AustinHackers/ahabadge/README.md

# AHA Badges

## DEF CON 24

See the [DEF CON 24](https://github.com/AustinHackers/ahabadge/tree/master/DEFCON%2024) sub folder under the master branch.

### v2

See the [version_2.x branch](https://github.com/AustinHackers/ahabadge/tree/version_2.x).

## Getting Help

Open an Issue but don't expect much.
