AustinHackers/ahabadge/DEFCON 24/README.md

# WARNING

Some v0 and v1 badges fail when plugged in to USB,
the MCU develops a short and destroys itself!

If you have a v0 or v1 badge install a 10uF cap between pins 4 and 8
(VSS and VREGIN) on the BREAKOUT1 header.

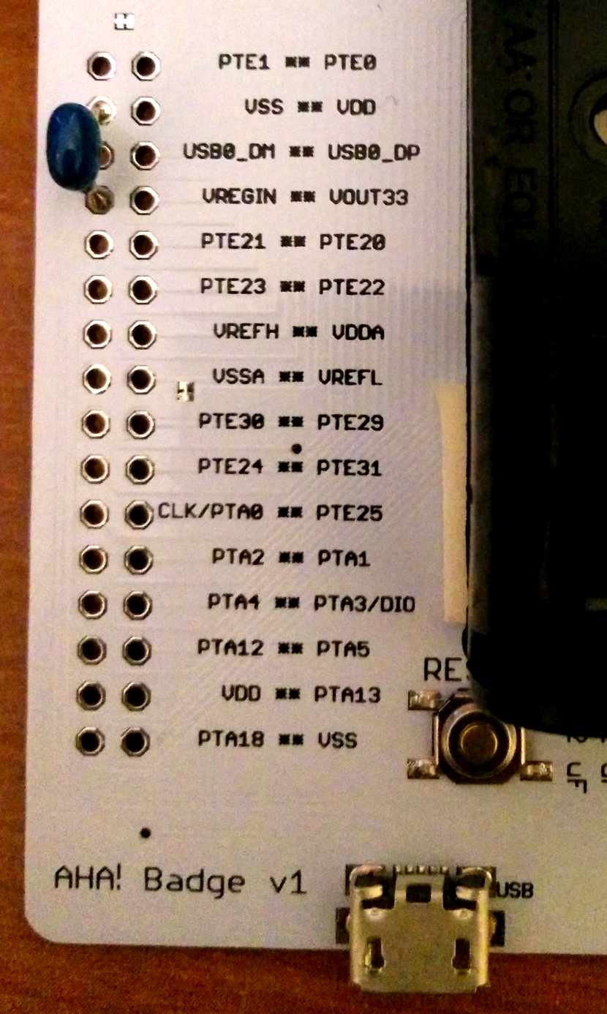
[picture p1: DEFCON 24/vregin_cap.jpg]
VREGIN capacitor


## Getting Started

Instructions for building firmware and flashing your badge is in
[DEFCON 24/laser-tag software/README](DEFCON%2024/laser-tag%20software/README).

## Getting Help

Open an Issue but don't expect much.
