AustinHackers/ahabadge/DEFCON 24/KSDK_1.2.0/platform/drivers/src/tpm/fsl_tpm_driver.c

/*
 * Copyright (c) 2014, Freescale Semiconductor, Inc.
 * All rights reserved.
 *
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
 * o Neither the name of Freescale Semiconductor, Inc. nor the names of its
 *   contributors may be used to endorse or promote products derived from this
 *   software without specific prior written permission.
 *
 * THIS SOFTWARE IS PROVIDED BY THE COPYRIGHT HOLDERS AND CONTRIBUTORS "AS IS" AND
 * ANY EXPRESS OR IMPLIED WARRANTIES, INCLUDING, BUT NOT LIMITED TO, THE IMPLIED
 * WARRANTIES OF MERCHANTABILITY AND FITNESS FOR A PARTICULAR PURPOSE ARE
 * DISCLAIMED. IN NO EVENT SHALL THE COPYRIGHT HOLDER OR CONTRIBUTORS BE LIABLE FOR
 * ANY DIRECT, INDIRECT, INCIDENTAL, SPECIAL, EXEMPLARY, OR CONSEQUENTIAL DAMAGES
 * (INCLUDING, BUT NOT LIMITED TO, PROCUREMENT OF SUBSTITUTE GOODS OR SERVICES;
 * LOSS OF USE, DATA, OR PROFITS; OR BUSINESS INTERRUPTION) HOWEVER CAUSED AND ON
 * ANY THEORY OF LIABILITY, WHETHER IN CONTRACT, STRICT LIABILITY, OR TORT
 * (INCLUDING NEGLIGENCE OR OTHERWISE) ARISING IN ANY WAY OUT OF THE USE OF THIS
 * SOFTWARE, EVEN IF ADVISED OF THE POSSIBILITY OF SUCH DAMAGE.
 */

#include "fsl_tpm_driver.h"
#include "fsl_clock_manager.h"

#if FSL_FEATURE_SOC_TPM_COUNT

/*******************************************************************************
 * Definitions
 ******************************************************************************/

/*******************************************************************************
 * Variables
 ******************************************************************************/
/*! Stores TPM clock source setting */
static tpm_clock_mode_t s_tpmClockSource = kTpmClockSourceNoneClk;

/*******************************************************************************
 * Code
 ******************************************************************************/

/*FUNCTION**********************************************************************
 *
 * Function Name : TPM_DRV_Init
 * Description   : Initializes the TPM driver.
 * This function will initialize the TPM module.
 *
 *END**************************************************************************/
tpm_status_t TPM_DRV_Init(uint32_t instance, const tpm_general_config_t * info)
{
    assert(instance < TPM_INSTANCE_COUNT);

    TPM_Type *tpmBase = g_tpmBase[instance];

    /*Enable TPM clock*/
    CLOCK_SYS_EnableTpmClock(instance);

    TPM_HAL_Reset(tpmBase, instance);

    /*trigger mode*/
    TPM_HAL_SetTriggerMode(tpmBase, info->isTriggerMode);
    TPM_HAL_SetStopOnOverflowMode(tpmBase, info->isStopCountOnOveflow);
    TPM_HAL_SetReloadOnTriggerMode(tpmBase, info->isCountReloadOnTrig);

    /*trigger source*/
    TPM_HAL_SetTriggerSrc(tpmBase, info->triggerSource);

    /*global time base*/
    TPM_HAL_EnableGlobalTimeBase(tpmBase, info->isGlobalTimeBase);

    /*Debug mode*/
    TPM_HAL_SetDbgMode(tpmBase, info->isDBGMode);

    NVIC_ClearPendingIRQ(g_tpmIrqId[instance]);
    INT_SYS_EnableIRQ(g_tpmIrqId[instance]);

    return kStatusTpmSuccess;
}

/*FUNCTION**********************************************************************
 *
 * Function Name : TPM_DRV_SetClock
 * Description   : Set TPM clock source.
 * This function will set the TPM clock source defined in the tpm_clock_source_t structure.
 * It will also set the clock divider.
 *
 *END**************************************************************************/
void TPM_DRV_SetClock(uint32_t instance, tpm_clock_source_t clock, tpm_clock_ps_t clockPs)
{
    assert(instance < TPM_INSTANCE_COUNT);

    TPM_Type *tpmBase = g_tpmBase[instance];

    /*Clock prescaler*/
    TPM_HAL_SetClockDiv(tpmBase, clockPs);

    if (clock == kTpmClockSourcNone)
    {
        s_tpmClockSource = kTpmClockSourceNoneClk;
    }
    else if ((clock == kTpmClockSourceModuleOSCERCLK) || (clock == kTpmClockSourceModuleHighFreq) ||
             (clock == kTpmClockSourceModuleMCGIRCLK))
    {
        CLOCK_SYS_SetTpmSrc(instance, (clock_tpm_src_t)clock);
        s_tpmClockSource = kTpmClockSourceModuleClk;
    }
    else if ((clock == kTpmClockSourceExternalCLKIN0) || (clock == kTpmClockSourceExternalCLKIN1))

    {
        CLOCK_SYS_SetTpmExternalSrc(instance, (sim_tpm_clk_sel_t)(clock - 4));
        s_tpmClockSource = kTpmClockSourceExternalClk;
    }
    else
    {
        s_tpmClockSource = kTpmClockSourceReservedClk;
    }

}

/*FUNCTION**********************************************************************
 *
 * Function Name : TPM_DRV_GetClock
 * Description   : Get the TPM clock frequency.
 * The function returns the frequency of the TPM clock.
 *
 *END**************************************************************************/
uint32_t TPM_DRV_GetClock(uint32_t instance)
{
    assert(instance < TPM_INSTANCE_COUNT);

    TPM_Type *tpmBase = g_tpmBase[instance];
    uint32_t freq = 0;
    uint32_t clockPs;

    /* Clock prescaler */
    clockPs = (1 << TPM_HAL_GetClockDiv(tpmBase));

    switch (s_tpmClockSource)
    {
        case kTpmClockSourceModuleClk:
            freq = CLOCK_SYS_GetTpmFreq(0) / clockPs;
            break;
        case kTpmClockSourceExternalClk:
            freq = CLOCK_SYS_GetTpmExternalFreq(instance) / clockPs;
            break;
        default:
            break;
    }

    return freq;
}

/*FUNCTION**********************************************************************
 *
 * Function Name : TPM_DRV_SetTimeOverflowIntCmd
 * Description   : Enable or disable the timer overflow interrupt
 * This function will enable or disable the TPM timer overflow (TOF) interrupt.
 *
 *END**************************************************************************/
void TPM_DRV_SetTimeOverflowIntCmd(uint32_t instance, bool overflowEnable)
{
    if (overflowEnable)
    {
        TPM_HAL_EnableTimerOverflowInt(g_tpmBase[instance]);
    }
    else
    {
        TPM_HAL_DisableTimerOverflowInt(g_tpmBase[instance]);
    }
}

/*FUNCTION**********************************************************************
 *
 * Function Name : TPM_DRV_SetChnIntCmd
 * Description   : Enable or disable the channel interrupt
 * This function will enable or disable the channel interrupt.
 *
 *END**************************************************************************/
void TPM_DRV_SetChnIntCmd(uint32_t instance, uint8_t channelNum, bool enable)
{
    if (enable)
    {
        TPM_HAL_EnableChnInt(g_tpmBase[instance], channelNum);
    }
    else
    {
        TPM_HAL_DisableChnInt(g_tpmBase[instance], channelNum);
    }
}

/*FUNCTION**********************************************************************
 *
 * Function Name : TPM_DRV_Deinit
 * Description   : Shuts down the TPM driver.
 * This function will deactivate the TPM driver.
 *
 *END**************************************************************************/
void TPM_DRV_Deinit(uint32_t instance)
{
    TPM_HAL_Reset(g_tpmBase[instance], instance);

    INT_SYS_DisableIRQ(g_tpmIrqId[instance]);

    /* disable clock for TPM.*/
    CLOCK_SYS_DisableTpmClock(instance);
}

/*FUNCTION**********************************************************************
 *
 * Function Name : TPM_DRV_PwmStop
 * Description   : Stops channel PWM.
 * This function will stop outputting the PWM signal on the channel.
 *
 *END**************************************************************************/
void TPM_DRV_PwmStop(uint32_t instance, tpm_pwm_param_t *param, uint8_t channel)
{
    assert((param->mode == kTpmEdgeAlignedPWM) || (param->mode == kTpmCenterAlignedPWM));
    assert(instance < TPM_INSTANCE_COUNT);
    assert(channel < g_tpmChannelCount[instance]);

    TPM_Type *tpmBase = g_tpmBase[instance];

    /* Set clock source to none to disable counter */
    TPM_HAL_SetClockMode(tpmBase, kTpmClockSourceNoneClk);

    TPM_HAL_DisableChn(tpmBase, channel);
}

/*FUNCTION**********************************************************************
 *
 * Function Name : TPM_DRV_PwmStart
 * Description   : Configures duty cycle, frequency and starts outputting PWM on specified channel.
 * This function will configure the channel for edge or center PWM mode and start outputting a
 * PWM signal.
 *
 *END**************************************************************************/
tpm_status_t TPM_DRV_PwmStart(uint32_t instance, tpm_pwm_param_t *param, uint8_t channel)
{
    uint32_t freq;
    uint16_t uMod, uCnv;

    assert(instance < TPM_INSTANCE_COUNT);
    assert(param->uDutyCyclePercent <= 100);
    assert(channel < g_tpmChannelCount[instance]);

    TPM_Type *tpmBase = g_tpmBase[instance];

    if (s_tpmClockSource == kTpmClockSourceNoneClk)
    {
        return kStatusTpmFail;
    }

    freq = TPM_DRV_GetClock(instance);

    /* When switching mode, disable channel first  */
    TPM_HAL_DisableChn(tpmBase, channel);

    switch(param->mode)
    {
        case kTpmEdgeAlignedPWM:
            uMod = freq / param->uFrequencyHZ - 1;
            uCnv = uMod * param->uDutyCyclePercent / 100;
            /* For 100% duty cycle */
            if(uCnv >= uMod)
            {
                uCnv = uMod + 1;
            }
            TPM_HAL_SetMod(tpmBase, uMod);
            TPM_HAL_SetChnCountVal(tpmBase, channel, uCnv);
            break;
        case kTpmCenterAlignedPWM:
            uMod = freq / (param->uFrequencyHZ * 2);
            uCnv = uMod * param->uDutyCyclePercent / 100;
            /* For 100% duty cycle */
            if(uCnv >= uMod)
            {
                uCnv = uMod + 1;
            }
            TPM_HAL_SetMod(tpmBase, uMod);
            TPM_HAL_SetChnCountVal(tpmBase, channel, uCnv);
            break;
        default:
            assert(0);
            break;
    }

    /* Set the requested PWM mode */
    TPM_HAL_EnablePwmMode(tpmBase, param, channel);

    /* Set the TPM clock */
    TPM_HAL_SetClockMode(tpmBase, s_tpmClockSource);

    return kStatusTpmSuccess;
}

/*FUNCTION**********************************************************************
 *
 * Function Name : TPM_DRV_CounterStart
 * Description   : Starts the TPM counter.
 * This function provides access to the TPM counter. The counter can be run in
 * Up-counting and Up-down counting modes.
 *
 *END**************************************************************************/
void TPM_DRV_CounterStart(uint32_t instance, tpm_counting_mode_t countMode, uint32_t countFinalVal,
                                 bool enableOverflowInt)
{
    assert(instance < TPM_INSTANCE_COUNT);

    TPM_Type *tpmBase = g_tpmBase[instance];
    uint32_t channel = 0;

    /* Set clock source to none to disable counter */
    TPM_HAL_SetClockMode(tpmBase, kTpmClockSourceNoneClk);

    /* Clear the overflow flag */
    TPM_HAL_ClearTimerOverflowFlag(tpmBase);
    TPM_HAL_SetMod(tpmBase, countFinalVal);

    /* Use TPM as counter, turn off all the channels */
    for (channel = 0; channel < g_tpmChannelCount[instance]; channel++)
    {
        TPM_HAL_DisableChn(tpmBase, channel);
    }

    if (countMode == kTpmCountingUp)
    {
        TPM_HAL_SetCpwms(tpmBase, 0);
    }
    else if (countMode == kTpmCountingUpDown)
    {
        TPM_HAL_SetCpwms(tpmBase, 1);
    }

    /* Activate interrupts if required */
    TPM_DRV_SetTimeOverflowIntCmd(instance, enableOverflowInt);

    /* Set the TPM clock */
    TPM_HAL_SetClockMode(tpmBase, s_tpmClockSource);
}

/*FUNCTION**********************************************************************
 *
 * Function Name : TPM_DRV_CounterStop
 * Description   : Stops the TPM counter.
 *
 *END**************************************************************************/
void TPM_DRV_CounterStop(uint32_t instance)
{
    /* Set clock source to none to disable counter */
    TPM_HAL_SetClockMode(g_tpmBase[instance], kTpmClockSourceNoneClk);
    /* Clear CPWMS bit after disable counter */
    TPM_HAL_SetCpwms(g_tpmBase[instance], 0);

    /* Disable the overflow interrupt */
    TPM_DRV_SetTimeOverflowIntCmd(instance, false);
}

/*FUNCTION**********************************************************************
 *
 * Function Name : TPM_DRV_CounterRead
 * Description   : Reads back the current value of the TPM counter.
 *
 *END**************************************************************************/
uint32_t TPM_DRV_CounterRead(uint32_t instance)
{
    assert(instance < TPM_INSTANCE_COUNT);

    return TPM_HAL_GetCounterVal(g_tpmBase[instance]);
}

/*FUNCTION**********************************************************************
 *
 * Function Name : TPM_DRV_InputCaptureEnable
 * Description   : Setup the channel for TPM input capture mode.
 * This function will setup the capture mode for a channel depending on what is provided in the mode
 * argument. Channel interrupts can be enabled or disabled by using the intEnable argument.
 *
 *END**************************************************************************/
void TPM_DRV_InputCaptureEnable(uint32_t instance, uint8_t channel, tpm_input_capture_mode_t mode,
                                         uint32_t countFinalVal, bool intEnable)
{
    assert(instance < TPM_INSTANCE_COUNT);

    TPM_Type *tpmBase = g_tpmBase[instance];

    /* Set clock source to none to disable counter */
    TPM_HAL_SetClockMode(tpmBase, kTpmClockSourceNoneClk);

    TPM_HAL_DisableChn(tpmBase, channel);
    TPM_HAL_ClearChnInt(tpmBase, channel);
    TPM_HAL_ClearCounter(tpmBase);
    TPM_HAL_SetCpwms(tpmBase, 0);
    TPM_HAL_SetMod(tpmBase, countFinalVal);
    TPM_HAL_SetChnMsnbaElsnbaVal(tpmBase, channel, (mode << TPM_CnSC_ELSA_SHIFT));

    TPM_DRV_SetChnIntCmd(instance, channel, intEnable);

    /* Set the TPM clock */
    TPM_HAL_SetClockMode(tpmBase, s_tpmClockSource);
}

/*FUNCTION**********************************************************************
 *
 * Function Name : TPM_DRV_GetChnVal
 * Description   : Reads back the current value of the TPM channel value register.
 *
 *END**************************************************************************/
uint32_t TPM_DRV_GetChnVal(uint32_t instance, uint8_t channel)
{
    assert(instance < TPM_INSTANCE_COUNT);

    return TPM_HAL_GetChnCountVal(g_tpmBase[instance], channel);
}

/*FUNCTION**********************************************************************
 *
 * Function Name : TPM_DRV_OutputCompareEnable
 * Description   : TPM output compare mode setup.
 * This function will setup the compare mode for a channel depending on what is provided in the mode
 * argument. Channel interrupts can be enabled or disabled by using the intEnable argument. The compare
 * value is provided in the matchVal argument.
 *
 *END**************************************************************************/
void TPM_DRV_OutputCompareEnable(uint32_t instance, uint8_t channel, tpm_output_compare_mode_t mode,
                                            uint32_t countFinalVal, uint32_t matchVal, bool intEnable)
{
    assert(instance < TPM_INSTANCE_COUNT);

    TPM_Type *tpmBase = g_tpmBase[instance];
    uint32_t cmpMode = 0;

    /* Set clock source to none to disable counter */
    TPM_HAL_SetClockMode(tpmBase, kTpmClockSourceNoneClk);

    TPM_HAL_DisableChn(tpmBase, channel);
    TPM_HAL_ClearChnInt(tpmBase, channel);
    TPM_HAL_ClearCounter(tpmBase);
    TPM_HAL_SetCpwms(tpmBase, 0);
    TPM_HAL_SetMod(tpmBase, countFinalVal);

    if ((mode == kTpmHighPulseOutput) || (mode == kTpmLowPulseOutput))
    {
        cmpMode = ((uint32_t)mode - 3) << TPM_CnSC_ELSA_SHIFT;
        TPM_HAL_SetChnMsnbaElsnbaVal(tpmBase, channel,
                                     ((0x3 << TPM_CnSC_MSA_SHIFT) | cmpMode));
    }
    else
    {
        cmpMode = mode << TPM_CnSC_ELSA_SHIFT;
        TPM_HAL_SetChnMsnbaElsnbaVal(tpmBase, channel,
                                     ((0x1 << TPM_CnSC_MSA_SHIFT) | cmpMode));
    }
    TPM_HAL_SetChnCountVal(tpmBase, channel, matchVal);

    TPM_DRV_SetChnIntCmd(instance, channel, intEnable);

    /* Set the TPM clock */
    TPM_HAL_SetClockMode(tpmBase, s_tpmClockSource);
}

/*FUNCTION**********************************************************************
 *
 * Function Name : TPM_DRV_IRQHandler
 * Description   : The handler function is called from the TPM interrupt handler
 * This function will clear the bits in the status register for the interrupt sources that are
 * enabled.
 *
 *END**************************************************************************/
void TPM_DRV_IRQHandler(uint32_t instance)
{
    uint16_t status = 0;
    uint16_t channel;
    TPM_Type *tpmBase = g_tpmBase[instance];

    /* Clear the status flags for the interrupts enabled */
    if (TPM_HAL_IsOverflowIntEnabled(tpmBase))
    {
        status = (1 << TPM_STATUS_TOF_SHIFT);
    }

    for (channel = 0; channel < g_tpmChannelCount[instance]; channel++)
    {
        if (TPM_HAL_IsChnIntEnabled(tpmBase, channel))
        {
            status |= (1u << channel);
        }
    }

    TPM_HAL_ClearStatusReg(tpmBase, status);
}

#endif /* FSL_FEATURE_SOC_TPM_COUNT */

/*******************************************************************************
 * EOF
 ******************************************************************************/
