AustinHackers/ahabadge/(commit log)

2015-09-12 Some initial work on a laser-tag badge
    [laser-tag.brd, laser-tag.sch]
2015-09-13 Added ground plane and power wires
    [laser-tag.brd]
2015-09-13 Added AHA shape to board outline
    [laser-tag.brd]
2015-09-13 Added HP 7-segment bubble display
    [laser-tag.brd, laser-tag.sch]
2015-09-13 Added photonics, removed bubble display
    I'm thinking of adding the bubble display back with a MAX6958/MAX6959
    to control it and possibly some buttons.
    [laser-tag.brd, laser-tag.sch]
2015-09-13 Added USB
    [laser-tag.brd, laser-tag.sch]
2015-09-14 Added 128x32 LCD display
    I haven't wired it up. Just seeing how it looks.
    [laser-tag.brd, laser-tag.sch]
2015-09-14 Moved stuff around to make room for the LCD
    [laser-tag.brd]
2015-09-15 Added a cutout for the laser and wired everything
    [laser-tag.brd, laser-tag.sch]
2015-09-15 Slapped some buttons on it
    [laser-tag.brd, laser-tag.sch]
2015-09-15 Make vias all the same size, change cutouts
    [laser-tag.brd, laser-tag.sch]
2015-09-15 Change cutouts again
    [laser-tag.brd, laser-tag.sch]
2015-09-20 Add LCD capacitor values
    [laser-tag.brd, laser-tag.sch]
2015-09-22 Changed to photodiode and added pingpong placement
    [laser-tag.brd, laser-tag.sch]
2015-09-26 New board design
    [laser-tag.brd, laser-tag.sch]
2015-09-26 Added AHA logo
    [laser-tag.brd, laser-tag.sch]
2015-09-26 Remove tStop polys that I missed
    [laser-tag.brd]
2015-09-26 Fixing polys for gerber output
    [laser-tag.brd, laser-tag.sch]
2015-09-26 Move ball to reference layer
    [laser-tag.brd]
2015-09-27 Fix transistor, tie VREFL low, add WS2812B
    [laser-tag.brd, laser-tag.sch]
2015-09-27 Fix backlight LED circuit
    Use a FET instead of a BJT since we're just switching it on and off
    and don't want to draw a lot of current from the MCU.
    [laser-tag.brd, laser-tag.sch]
2015-09-29 DAC laser modulation test
2015-10-03 Power usage now < 1mA
    It doesn't even register on my meter anymore!
    [main.c]
2015-10-04 DMA to DAC
2015-10-13 Added a voltage divider for VREFH input
    This way we can get higher resolution in the range of voltages
    we get from the photodiodes.
    [laser-tag.brd, laser-tag.sch]
2015-10-15 Crappy automatic gain control for the CMP
    The theory seem to be sound, it just needs tuning and probably
    filtering. Then we have to figure out how to recover actual data.
2015-10-18 Connect CMP0_OUT to LPUART1_RX
    [laser-tag.brd, laser-tag.sch]
2015-10-18 Added solder jumpers for future expansion
    [laser-tag.brd, laser-tag.sch]
2015-10-18 Switched to two large photodiodes
    [laser-tag.brd, laser-tag.sch]
2015-10-20 Tweak AGC, wire laser to switch1
    [laser-tag.brd, laser-tag.sch]
2015-10-23 Remove VREFH divider
    Seems like we have enough resolution in the CMP DAC without it.
    [laser-tag.brd, laser-tag.sch]
2015-10-24 Mount photodiodes flush
    [laser-tag.brd, laser-tag.sch]
2015-10-27 Changes to get the LCD working
    [laser-tag.brd, laser-tag.sch]
2015-11-01 Added 2.6" EPD and rotated board to fit Eagle free
    [laser-tag.brd, laser-tag.sch]
2015-11-01 Fix cutout width
    [laser-tag.brd, laser-tag.sch]
2015-11-02 Wired up EPD except for busy and discharge signals
    [laser-tag.brd, laser-tag.sch]
2015-11-02 Layout for breakout headers
    [laser-tag.brd, laser-tag.sch]
2015-11-02 Finish layout for the display
    [laser-tag.brd]
2015-11-03 Wired up switches
    [laser-tag.brd, laser-tag.sch]
2015-11-11 Testing RGB LED
2015-11-11 Rotate switch for alternative keycap
    [laser-tag.brd, laser-tag.sch]
2015-11-12 Added LED and wired some stuff up
    [laser-tag.brd, laser-tag.sch]
2015-11-25 Actually libnewlib-arm-none-eabi
2015-11-25 Fix stupid FET wiring
    [laser-tag.brd, laser-tag.sch]
2015-11-25 Moved laser to PTE0
    [laser-tag.brd, laser-tag.sch]
2015-11-25 Driving the laser with LPUART_TX
2015-11-26 Add buzzer
    [laser-tag.brd, laser-tag.sch]
2015-11-26 Finishing up the layout
    [laser-tag.brd, laser-tag.sch]
2015-11-26 DRC fixes
    [laser-tag.brd]
2015-11-26 Add a bypass cap for the LED
    [laser-tag.brd, laser-tag.sch]
2015-11-26 Useful labels
    [laser-tag.brd]
2015-11-26 Add name and version number
    [laser-tag.brd]
2015-11-27 Changed text to vector
    It gets printed as vector anyway when making gerbers. This way we can
    fix text placement.
    [laser-tag.brd]
2016-01-04 Hold up button, not down, oops
    [laser-tag.brd]
2016-01-05 Use S1 for music and S2 for the laser
2016-01-06 Add pulldown for T1 gate
    [laser-tag.brd, laser-tag.sch]
2016-01-06 Better mounting for the ball
    [laser-tag.brd]
2016-01-07 Laser tag demo code
    You can select what data to send the other badge using the
    up/down/left/right keys. Then use the trigger to fire the laser!
    Up: Light LED red
    Left: Light LED green
    Right: Light LED blue
    Down: Start playing music (press any key to stop)
2016-01-28 Some initial progress
    I'm not getting the right response to command 0x71 and I think it has
    something to do with initializing the display (reset). I can't seem to
    get PTA20 to go low.
    [epaper.c, main.c]
2016-02-23 Turn on those charge pumps!
2016-03-28 Fix typo in KSDK code
    [fsl_spi_dma_irq.c]
2016-03-28 Use DMA SPI transfers
    This paints the display about 2x faster!
2016-03-29 Select button does image scrolling
2016-03-29 Choose a better character for music
    If you shorten the pulses for B you get a !.
    [main.c]
2016-03-29 Second battery for more power
    [laser-tag.brd, laser-tag.sch]
2016-04-16 Remove discharge FETs and use PTA19 for EPD reset
    [laser-tag.brd, laser-tag.sch]
2016-04-16 Using PTA19 for EPD reset
    This code will not work on V0 badges anymore. You'll need to remove
    Q1 and Q2 and cut the trace on the top going to breakout pin 34 and
    wire it to pin 33.
    [epaper.c]
2016-04-16 Added #define HAS_RESET for new vs old badges
    V0 badges should define it as 0, newer badges with EPD RESET wired to
    PTA19 should define it as 1.
    [epaper.c]
2016-04-18 Abort stuck SPI transfers
    [epaper.c, main.c]
2016-04-19 Make compatible with V0 badges again
    Since we don't need to control reset to fix EPD stuck problems
    wire it back to PTA20 and revert the code changes.
    [laser-tag.brd, laser-tag.sch]
2016-04-19 Don't fire the laser continuously
    This should really save on power and it's likely to work at even lower
    battery voltage. We probably don't need the 2nd battery now.
2016-04-19 Switch to micro-USB connector
    [laser-tag.brd, laser-tag.sch]
2016-04-19 Added fiducials
    [laser-tag.brd, laser-tag.sch]
2016-04-26 Replace T1 with Q1
    [laser-tag.brd, laser-tag.sch]
2016-04-26 Battery protection circuit
    [laser-tag.brd, laser-tag.sch]
2016-04-26 Better microUSB connector, v1 on silkscreen
    [laser-tag.brd, laser-tag.sch]
2016-04-26 Revert "Battery protection circuit"
    This reverts commit 69dbc586ce164c6a939ac46ac2dad6727082318c.
    [laser-tag.brd, laser-tag.sch]
2016-04-26 Change J2 to closed
    [laser-tag.brd, laser-tag.sch]
2016-04-27 Add reset button
    [laser-tag.brd, laser-tag.sch]
2016-04-27 Move J3 away from R1
    [laser-tag.brd]
2016-04-27 DRC approvals
    [laser-tag.brd]
2016-05-09 Prevent cue_next_image from being optimized out
    [main.c]
2016-05-18 Tiny laser pulses are hard to aim
2016-06-11 Some more details on USB power
2016-06-11 Nevermind the cut
2016-06-21 Add bypass cap on VREGIN
    [laser-tag.brd, laser-tag.sch]
2016-06-28 RFM69HCW daughterboard
    [daughterboard.brd, daughterboard.sch]
2016-07-04 Don't bother with DMA since we're busy-waiting
2016-07-14 Label the header to guide installation
    [daughterboard.brd]
2019-08-26 move everything in to DEFCON 24 folder
    [daughterboard.brd, daughterboard.sch, laser-tag.brd, laser-tag.sch]
2019-08-26 remove everything from parent folder
    [daughterboard.brd, daughterboard.sch, laser-tag.brd, laser-tag.sch]
